UCSD-ECEMAE-148/148-fall-2025-final-project-fall-2025-final-project-team-1/CAD/Electronics mount back.step

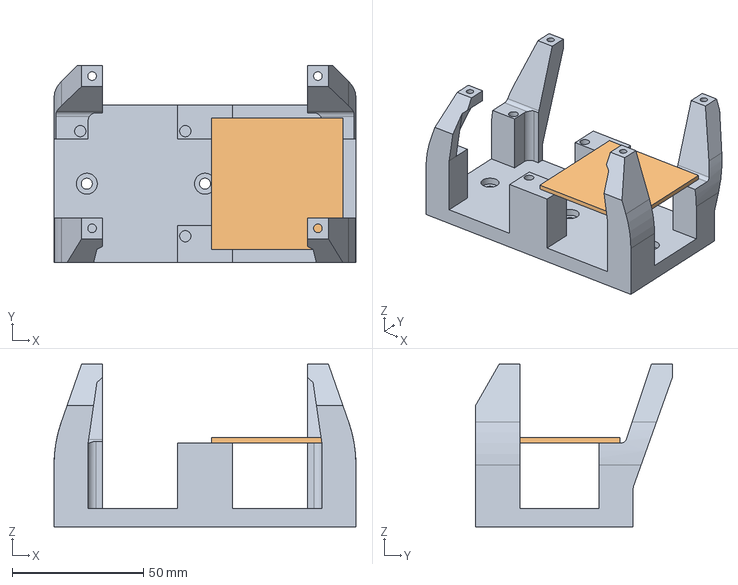
[picture p8: CAD file, 2025-12-14]
CAD/Electronics mount back.step
115.0 x 75.0 x 62.0 mm
