UCSD-ECEMAE-148/148-fall-2025-final-project-fall-2025-final-project-team-1/CAD/Steering absolute encoder.step

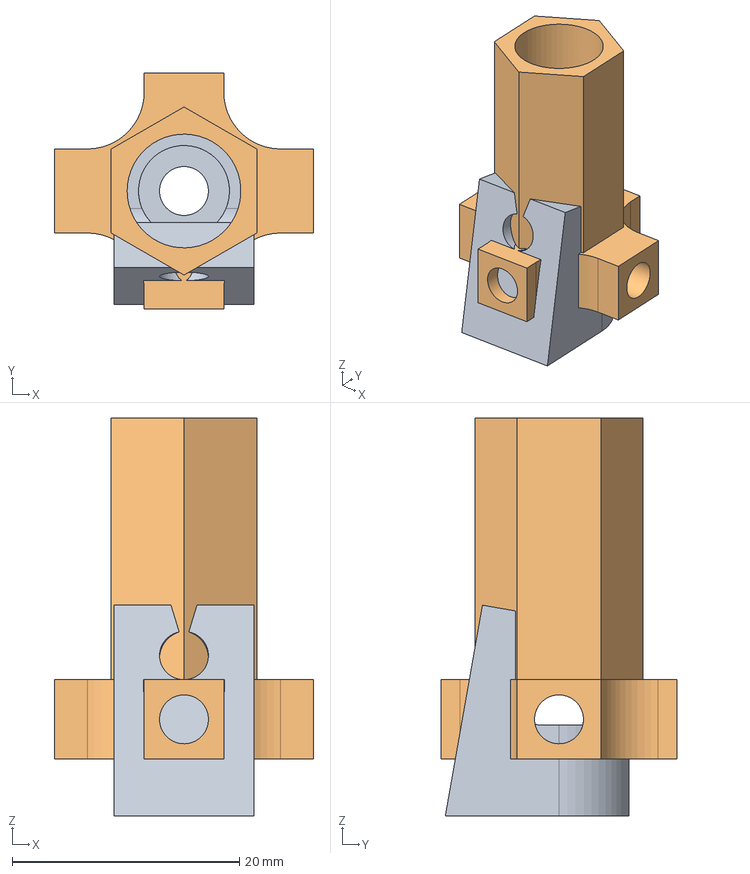
[picture p9: CAD file, 2025-12-14]
CAD/Steering absolute encoder.step
22.8 x 20.7 x 35.0 mm
