UCSD-ECEMAE-148/148-fall-2025-final-project-fall-2025-final-project-team-1/CAD/H bridge Mount Front.step

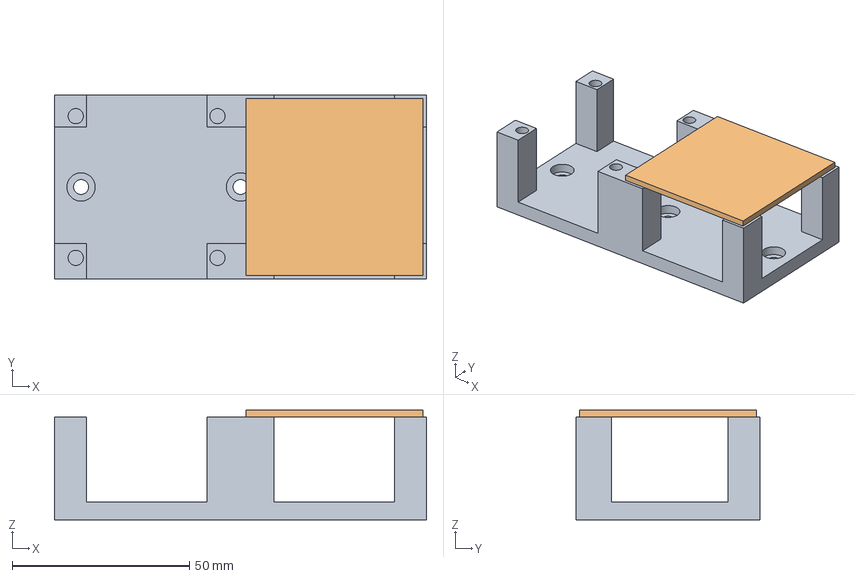
[picture p10: CAD file, 2025-12-14]
CAD/H bridge Mount Front.step
105.0 x 52.0 x 31.0 mm
