UCSD-ECEMAE-148/148-fall-2025-final-project-fall-2025-final-project-team-1/CAD/Arduino front mount.step

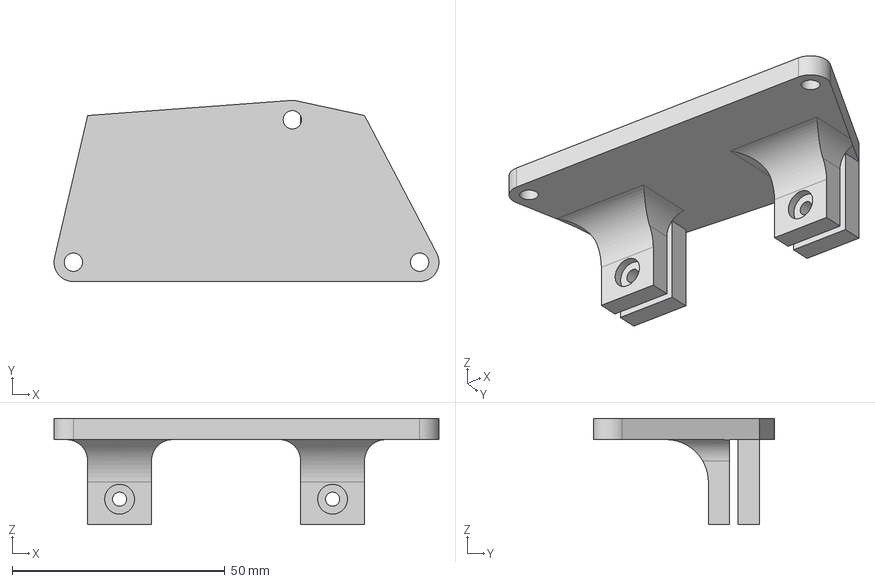
[picture p11: CAD file, 2025-12-14]
CAD/Arduino front mount.step
90.4 x 42.5 x 25.0 mm
