UCSD-ECEMAE-148/148-fall-2025-final-project-fall-2025-final-project-team-1/CAD/Encoder Mount.step

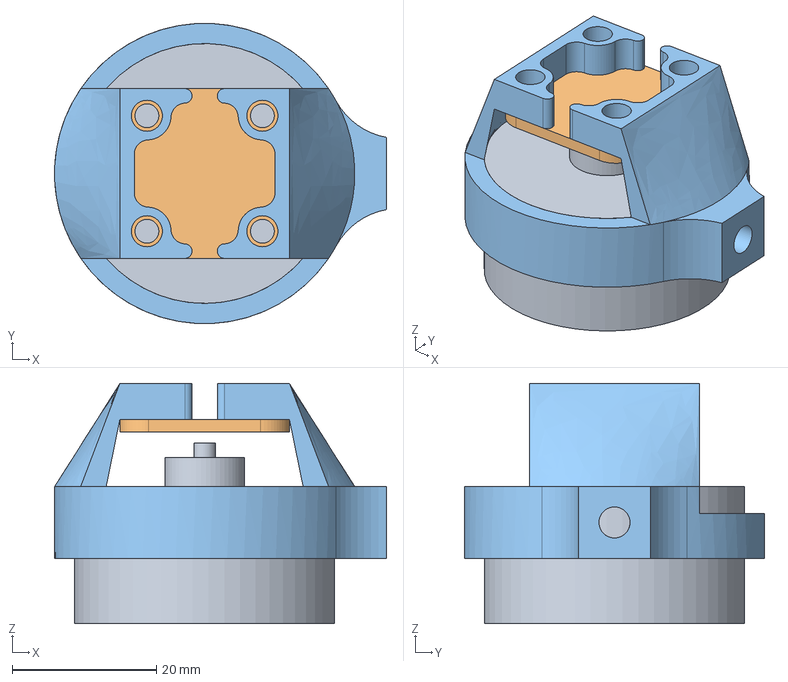
[picture p12: CAD file, 2025-12-14]
CAD/Encoder Mount.step
46.0 x 41.6 x 33.2 mm
