UCSD-ECEMAE-148/148-fall-2025-final-project-fall-2025-final-project-team-1/CAD/Steering spacer.step

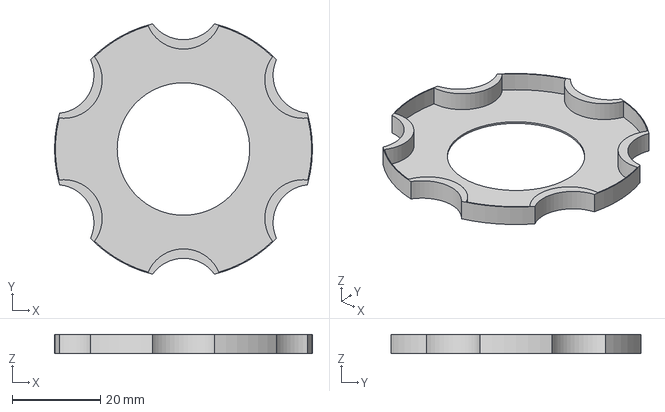
[picture p13: CAD file, 2025-12-14]
CAD/Steering spacer.step
58.4 x 56.7 x 4.40 mm
