UCSD-ECEMAE-148/148-fall-2025-final-project-fall-2025-final-project-team-1/(list of files, cad)

Other CAD files:
CAD/Arduino front mount.f3d
CAD/Electronics mount back.f3d
CAD/Encoder Mount.f3d
CAD/H bridge Mount Front.f3d
CAD/Steering absolute encoder.f3d
CAD/Steering spacer.f3d
